tortuoise/mov-pwrcon/pwrcon_1.kicad_pcb

## KiCad design pwrcon_1.kicad_pcb (2020-10-05)

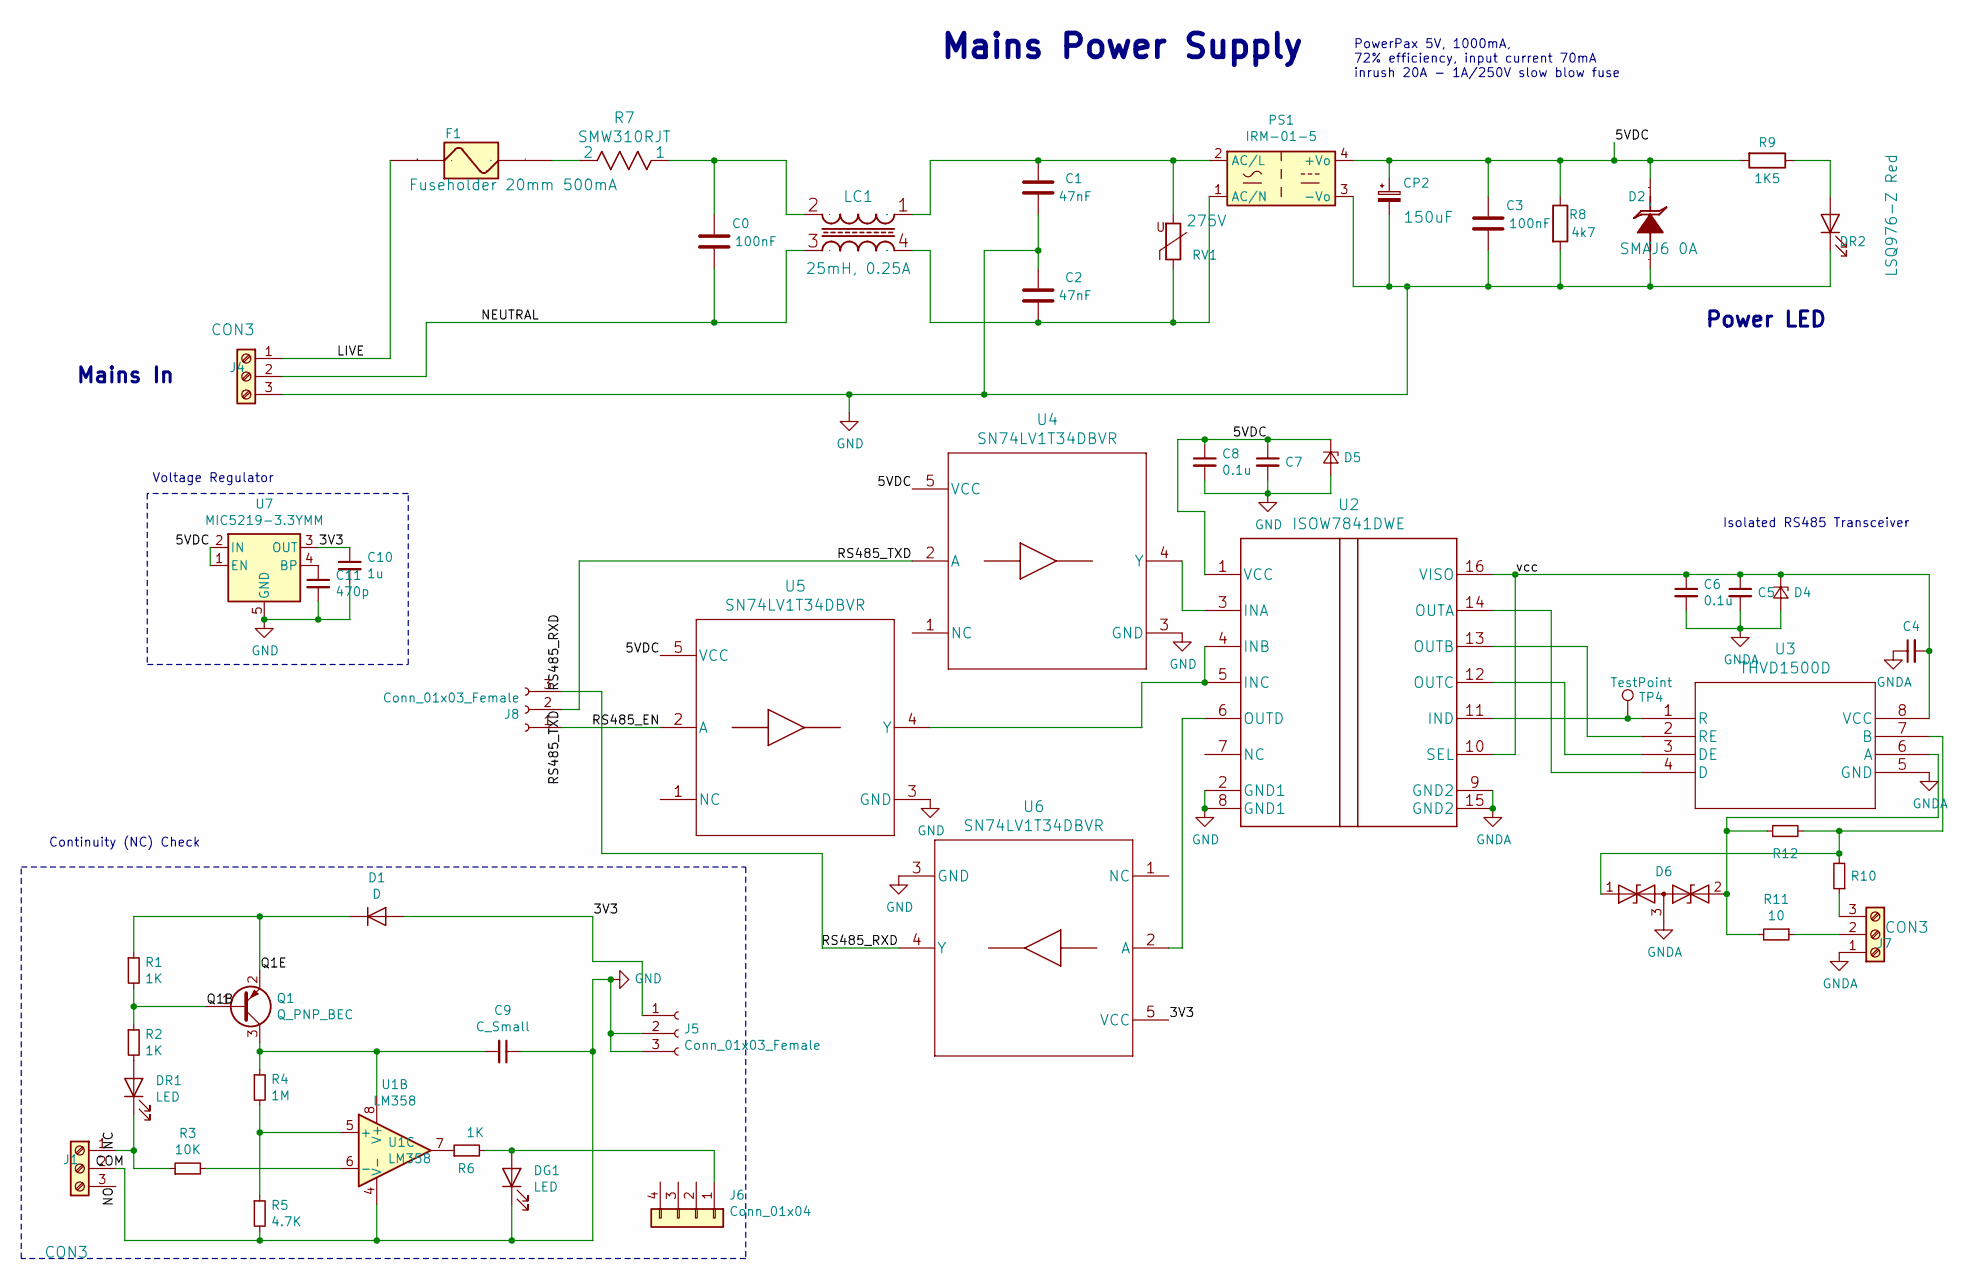
[picture p1: schematic pwrcon_1.sch]

Parts:
C0: 100nF; C_Rect_L18.0mm_W5.0mm_P15.00mm_FKS3_FKP3; PartNo ECQU2A104ML
C1, C2: 47nF; C_Rect_L10.0mm_W4.0mm_P7.50mm_MKS4; PartNo BFC233660473
C3: 100nF; C_0603_1608Metric_Pad1.05x0.95mm_HandSolder; MFG Part Num EMK107B7104KAHT
C4, C6, C8: 0.1u; C_0603_1608Metric_Pad1.05x0.95mm_HandSolder; MFG Part Num C0603C104J4RACTU
C5, C7: 10u; C_0603_1608Metric_Pad1.05x0.95mm_HandSolder; MFG Part Num C0603C106M9PACTU
C9: C_Small; C_0603_1608Metric_Pad1.05x0.95mm_HandSolder; MFG Part Num ‎EMK107B7104KAHT‎
C10: 1u; C_0603_1608Metric_Pad1.05x0.95mm_HandSolder
C11: 470p; C_0603_1608Metric_Pad1.05x0.95mm_HandSolder
CP2: 150uF; CP_EIA-7343-20_Kemet-V_Pad2.25x2.55mm_HandSolder; PartNo TRJD157K010R0150 / T495V157M010ATE150
D1: D; D_SOD-123; MFG Part Num BAV16W-7-F
D2: SMAJ6 0A; D_SMA; PartNo SMAJ6.0A
D4, D5: D_Zener_Small; D_SMB_Handsoldering; MFG Part Num 1SMB5919BT3G
D6: CDSOT23-SM712; SOT-23; MFG Part Num CDSOT23-SM712
DG1: LED; LED_0603_1608Metric_Pad1.05x0.95mm_HandSolder; MFG Part Num SML-D12M8WT86
DR1: LED; LED_0603_1608Metric_Pad1.05x0.95mm_HandSolder; MFG Part Num SML-D12V8WT86
DR2: LSQ976-Z Red; LED_0603_1608Metric_Pad1.05x0.95mm_HandSolder; PartNo LS Q976-NR-1
F1: Fuseholder 20mm 500mA; Fuseholder_Cylinder-5x20mm_Schurter_0031_8201_Horizontal_Op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; PartNo 0031.8201
J1, J4: CON3; PhoenixContact_MCV_1,5_3-G-5.08_1x03_P5.08mm_Vertical; MFG Part Num ED365/3
J5, J8: Conn_01x03_Female; PinSocket_1x03_P2.54mm_Vertical
J6: Conn_01x04; PinSocket_1x04_P2.54mm_Vertical
J7: CON3; PhoenixContact_MCV_1,5_3-G-5.08_1x03_P5.08mm_Vertical; PartNo ED365/3
LC1: 25mH, 0.25A; choke_wurth_744862250; PartNo 744862250
PS1: IRM-01-5; Converter_ACDC_MeanWell_IRM-02-xx_THT; MFG Part Num IRM-01-5
Q1: Q_PNP_BEC; SOT-23_Handsoldering; MFG Part Num FMMT718
R1, R2, R6: 1K; R_0603_1608Metric; MFG Part Num ESR03EZPJ102
R3: 10K; R_0603_1608Metric
R4: 1M; R_0603_1608Metric; MFG Part Num RCS06031M00FKEA
R5: 4.7K; R_0603_1608Metric_Pad1.05x0.95mm_HandSolder; MFG Part Num ESR03EZPJ472
R7: SMW310RJT; MFG Part Num SMW310RJT
R8: 4k7; R_0805_2012Metric_Pad1.15x1.40mm_HandSolder; MFG Part Num ERJ-P06J472V
R9: 1K5; R_0603_1608Metric; MFG Part Num ESR03EZPJ152
R10, R11: 10; R_2512_6332Metric_Pad1.52x3.35mm_HandSolder; MFG Part Num CRCW251210R0FKEG
R12: 120; R_0603_1608Metric_Pad1.05x0.95mm_HandSolder; MFG Part Num CRCW0603120RJNEA
RV1: 275V; RV_Disc_D7mm_W4mm_P5mm; PartNo 820572711
TP4: TestPoint; TestPoint_Loop_D1.80mm_Drill1.0mm_Beaded
U1: LM358; DIP-8_W7.62mm
U2: ISOW7841DWE; MFG Part Num ISOW7841D
U3: THVD1500D; MFG Part Num THVD1500DR
U4, U5, U6: SN74LV1T34DBVR; MFG Part Num SN74LV1T34DBVR
U7: MIC5219-3.3YMM; MSOP-8_3x3mm_P0.65mm; MFG Part Num MIC5219-3.3YMM

Connections:
/3V3: C10.1, D1.2 (A), J5.1, U6.5 (VCC), U7.3 (OUT)
/5VDC: C3.2, C7.1, C8.1, CP2.1, D2.1 (CATHODE), D5.1 (K), PS1.4 (+Vo), R8.1, R9.2, U2.1 (VCC), U4.5 (VCC), U5.5 (VCC), U7.1 (EN), U7.2 (IN)
/LIVE: F1.1, J4.1
/NC: DR1.1 (K), J1.1, R3.1
/NEUTRAL: C0.1, J4.2, LC1.3
/Q1B: Q1.1 (B), R1.2, R2.1
/Q1E: D1.1 (K), Q1.2 (E), R1.1
/RS485_EN: J8.1, U5.2 (A)
/RS485_RXD: J8.3, U6.4 (Y)
/RS485_TXD: J8.2, U4.2 (A)
/vcc: C4.2, C5.1, C6.1, D4.1 (K), U2.10 (SEL), U2.16 (VISO), U3.8 (VCC)
GND: C1.1, C2.2, C3.1, C7.2, C8.2, C9.1, C10.2, C11.2, CP2.2, D2.2 (ANODE), D5.2 (A), DG1.1 (K), DR2.1 (K), J1.2, J4.3, J5.2, J5.3, PS1.3 (-Vo), R5.2, R8.2, U1.4 (V-), U2.2 (GND1), U2.8 (GND1), U4.3 (GND), U5.3 (GND), U6.3 (GND), U7.5 (GND), U7.6 (GND), U7.7 (GND), U7.8 (GND)
GNDA: C4.1, C5.2, C6.2, D4.2 (A), D6.3 (common), J7.1, U2.9 (GND2), U2.15 (GND2), U3.5 (GND)
unnamed: C0.2, LC1.2, R7.1
unnamed: C1.2, LC1.1, PS1.2 (AC/L), RV1.2
unnamed: C2.1, LC1.4, PS1.1 (AC/N), RV1.1
unnamed: C9.2, Q1.3 (C), R4.1, U1.8 (V+)
unnamed: C11.1, U7.4 (BP)
unnamed: D6.1 (A1), R10.2, R12.2, U3.7 (B)
unnamed: D6.2 (A2), R11.2, R12.1, U3.6 (A)
unnamed: DG1.2 (A), J6.1, R6.2
unnamed: DR1.2 (A), R2.2
unnamed: DR2.2 (A), R9.1
unnamed: F1.2, R7.2
unnamed: J7.2, R11.1
unnamed: J7.3, R10.1
unnamed: R3.2, U1.6 (-)
unnamed: R4.2, R5.1, U1.5 (+)
unnamed: R6.1, U1.7
unnamed: TP4.1, U2.11 (IND), U3.1 (R)
unnamed: U2.3 (INA), U4.4 (Y)
unnamed: U2.4 (INB), U2.5 (INC), U5.4 (Y)
unnamed: U2.6 (OUTD), U6.2 (A)
unnamed: U2.12 (OUTC), U3.3 (DE)
unnamed: U2.13 (OUTB), U3.2 (RE)
unnamed: U2.14 (OUTA), U3.4 (D)

Notes on the sheet:
Mains Power Supply
PowerPax 5V, 1000mA, 72% efficiency, input current 70mA inrush 20A - 1A/250V slow blow fuse
Mains In
Isolated RS485 Transceiver
Power LED
Voltage Regulator
Continuity (NC) Check

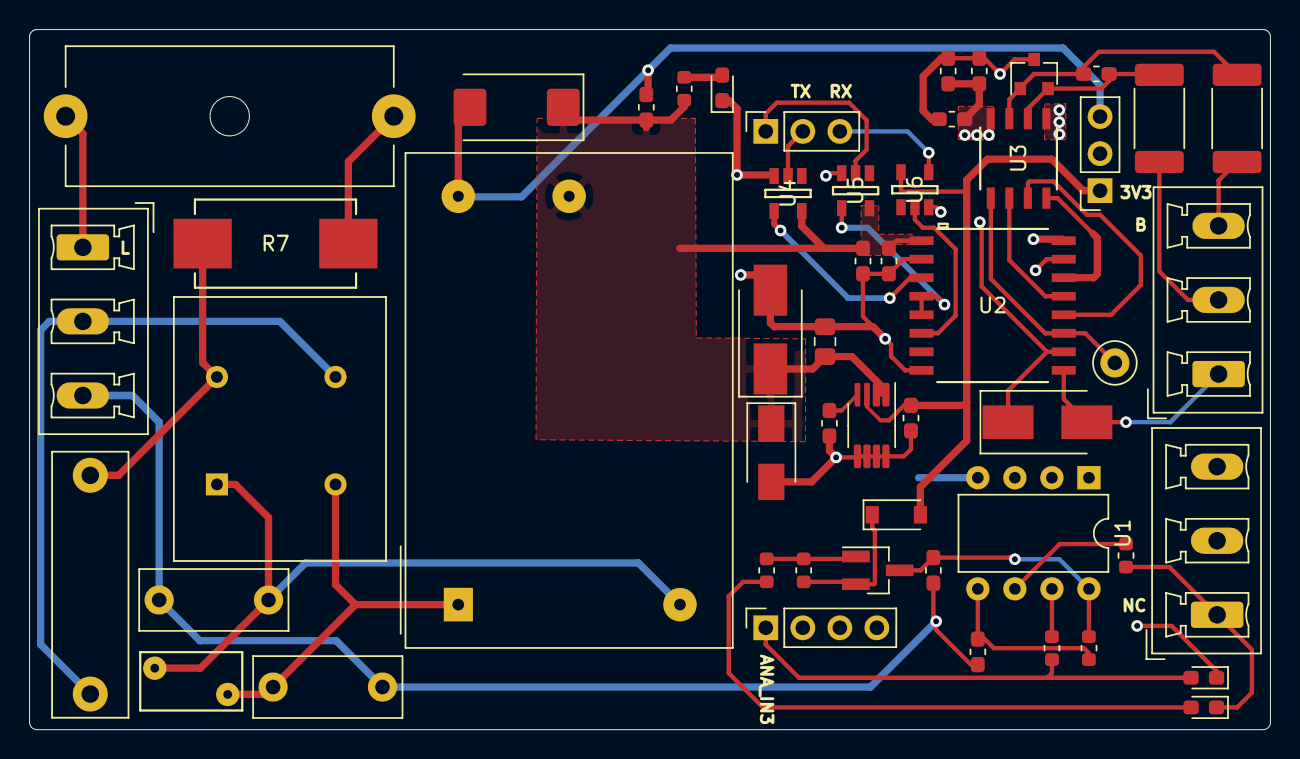
[picture p2: board pwrcon_1.kicad_pcb from above]

Board: 2 copper layers, 85.1 x 48.0 mm, 52 parts (0 on the bottom side), 36 nets.
