tortuoise/mov-pwrcon/(threads)

Thread 1 (2021-09-28):

Power supply of 5V 1000mA

armandorl, 2021-09-28:
Hi,

Nice project, thanks for sharing, quick question/issue: I see you use IRM-01-5, which is actually providing an output of 200mA for 5V. However the descrption in the schematics says 5V 1000mA.

Is there something that I do not see that ends up providing 1000mA or is this an issue?

Thanks

Closed 2025-02-21.
