tortuoise/mov-pwrcon/(commit log)

2020-01-23 Flipped the transistor so it lines up with footprint
    [pwrcon_1.sch]
2020-02-06 Changed pcb file for transistor flip in previous commit. Changed PSU module name in schematic
    [pwrcon_1.kicad_pcb, pwrcon_1.sch]
2020-09-16 Changed module to 5V, added 3V3 regulator and isolated RS485 transceiver, changed to SMD
    [pwrcon_1.kicad_pcb, pwrcon_1.sch]
2020-09-16 Preliminary routing
    [pwrcon_1.kicad_pcb, pwrcon_1.sch]
2020-09-17 More routing, component footprints finalised and missing ones added into repo
    [pwrcon_1.kicad_pcb, pwrcon_1.sch]
2020-09-21 Aisler fab submit
    [pwrcon_1.kicad_pcb, pwrcon_1.sch]
2020-09-22 Flipped varistor and led in schematic (no difference to board), cleaned up project/global footprint libraries
    [pwrcon_1.kicad_pcb, pwrcon_1.sch]
2020-10-05 Added missing 5VDC connection to isolator (isow7841dwe) and created new net vcc between isolator and esd/transceiver(thvd1500d). Changed layout.
    [pwrcon_1.kicad_pcb, pwrcon_1.sch]
